filip-w/PDM/README.md

# Power Distribution Module (PDM)

## Overview

The Power Distribution Module (PDM) is an Arduino-based module designed to manage and control power distribution efficiently. It allows for remote control of connected loads, making it ideal for applications in automotive, robotics, and industrial automation.

## Features

Arduino-based: Easily programmable and customizable.

Remote Control: Can be controlled via CAN bus.

Multiple Outputs: Distributes power to various components via high side drivers.

Overcurrent Protection: Current measurement ensures safe operation.

Compact and Efficient: Designed for the DIY-entusiast with jellybean parts.

## Librarys used
+ **FIR filter** by Leeman Geophysical LLC
+ **autowp-mcp2515** by autowp
+ **Adafruit MAX31855 library** by Adafruit

## Hardware

PDM
Skärmbild 2025-03-13 180137



### Tindie Store
I sell complete kits on my Tindie store.
