filip-w/PDM/(commit log)

2023-11-14 adding interrupt test code
2023-11-18 testing current sensors
2023-11-19 troubleshooting Interrupt
2024-01-28 new board testing.
2024-05-09 add library for soft PWM
2025-02-25 CAN interrupt filter
2025-03-08 Can control message interrupt and decoding
2025-03-10 read tripped fuse in loop
2025-03-12 adding system current limit
2025-03-12 adding per channel current limit
2025-03-12 move current sensing object inside struct, with pointer
2025-03-18 adding value description on fuse tripped signal
